xIBlackBird/furuta-pendulum/Pendel Down.jpeg

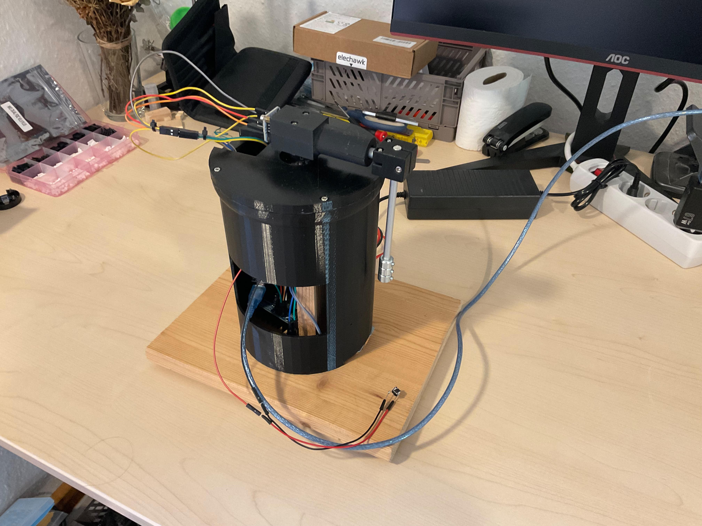
Pendel Down.jpeg
