xIBlackBird/furuta-pendulum/Pendel Up.jpeg

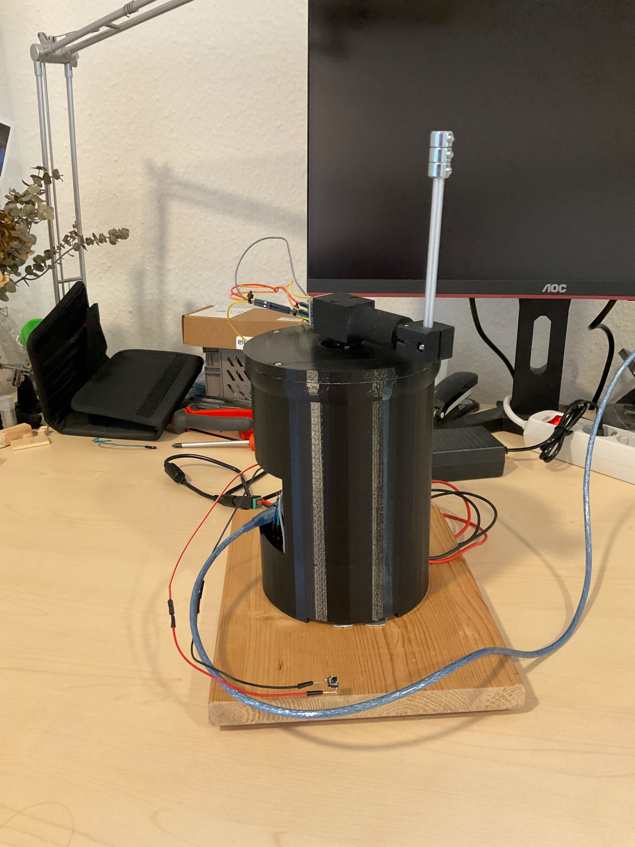
Pendel Up.jpeg
