xIBlackBird/furuta-pendulum/CAD/Zusammengesetzter Motorarm.SLDASM

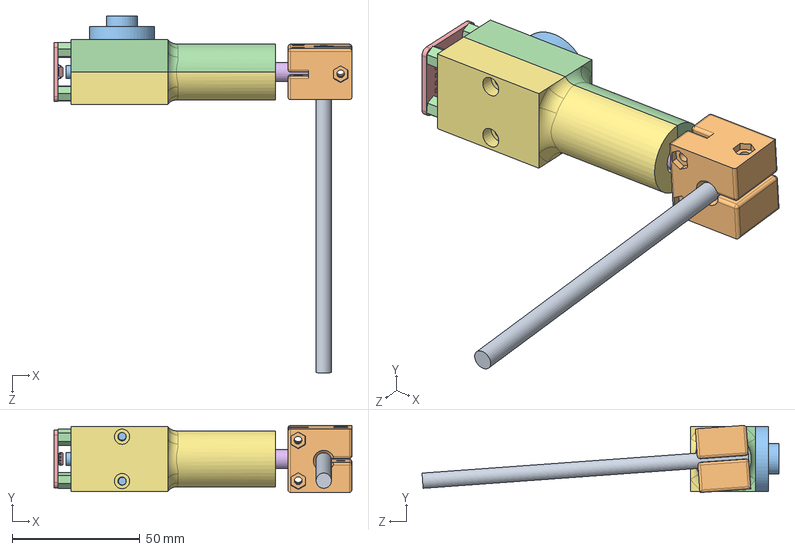
[picture p3: CAD file, 2026-09-04]
CAD/Zusammengesetzter Motorarm.SLDASM
116.6 x 26.3 x 139.8 mm
Motorarm_Unten_Link
Kupplung
M3 Mutter x 5
Kugellager x 2
Gewindeeinsätze x 8
Motorarm_Oben_Link
Welle
AS5600
Abstandshalter M3_5mm x 4
Magnet
Verbindung_Welle_Pendel
Pendelstange
