xIBlackBird/furuta-pendulum/CAD/Abdenkung Deckel.SLDPRT

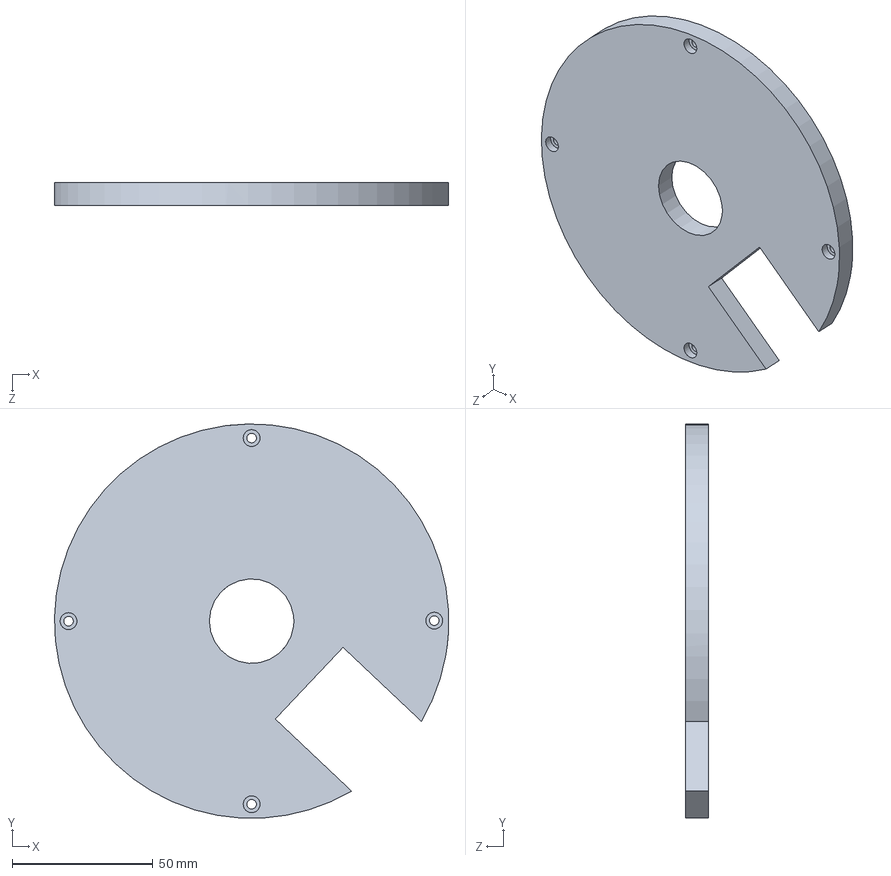
[picture p4: CAD file, 2026-10-30]
CAD/Abdenkung Deckel.SLDPRT
139.9 x 139.9 x 8.00 mm
