xIBlackBird/furuta-pendulum/CAD/Dateien zum Druck/Arduino Nano case.stl

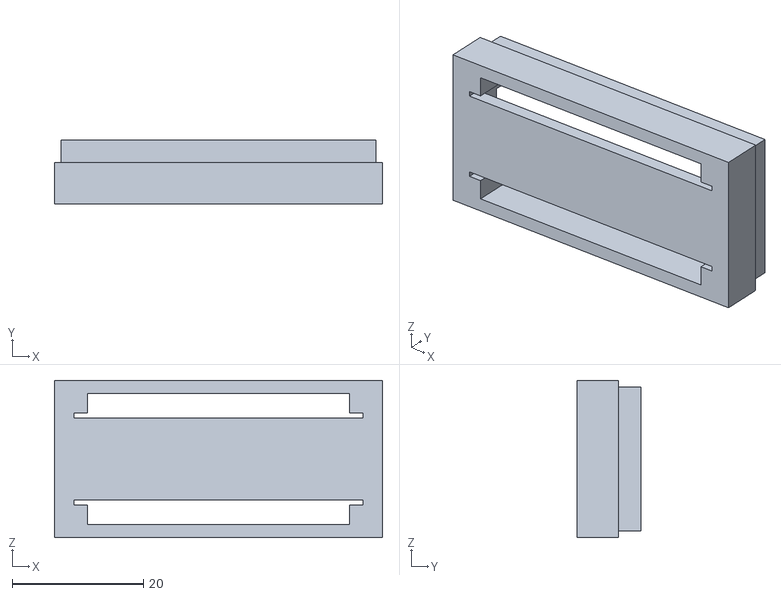
[picture p5: CAD file, 2026-10-30]
CAD/Dateien zum Druck/Arduino Nano case.stl
50.0 x 9.75 x 24.0
