xIBlackBird/furuta-pendulum/CAD/Motorarm Teile/Motorarm_Oben_Link.SLDPRT

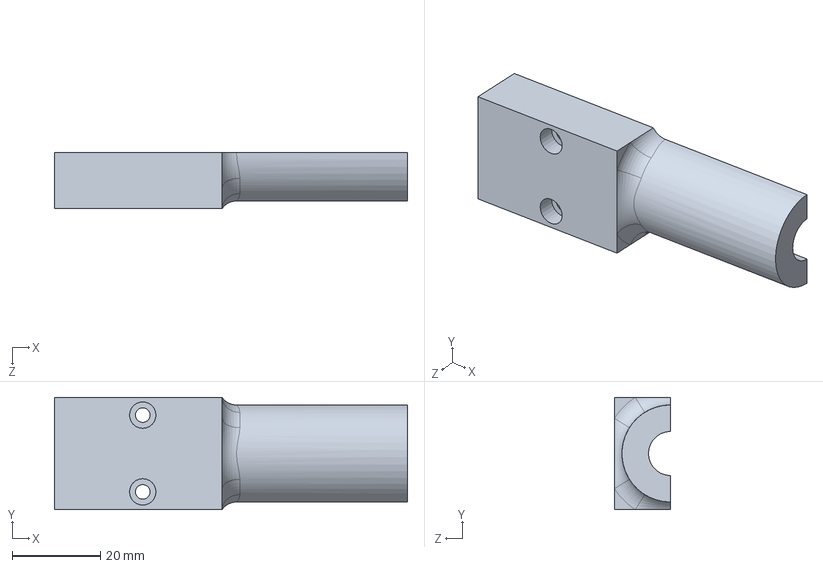
[picture p6: CAD file, 2026-09-04]
CAD/Motorarm Teile/Motorarm_Oben_Link.SLDPRT
80.0 x 25.4 x 12.7 mm
