xIBlackBird/furuta-pendulum/CAD/Abdenkung Zylinder.SLDPRT

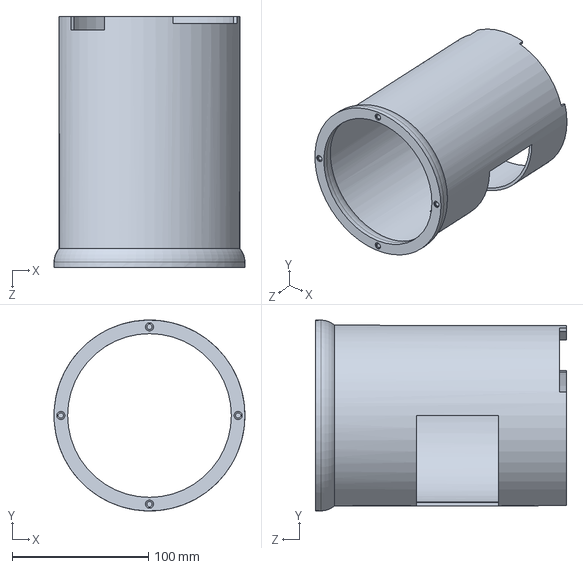
[picture p7: CAD file, 2026-10-30]
CAD/Abdenkung Zylinder.SLDPRT
140.0 x 139.9 x 184.0 mm
