xIBlackBird/furuta-pendulum/CAD/Dateien zum Druck/Arduino Nano Cover.stl

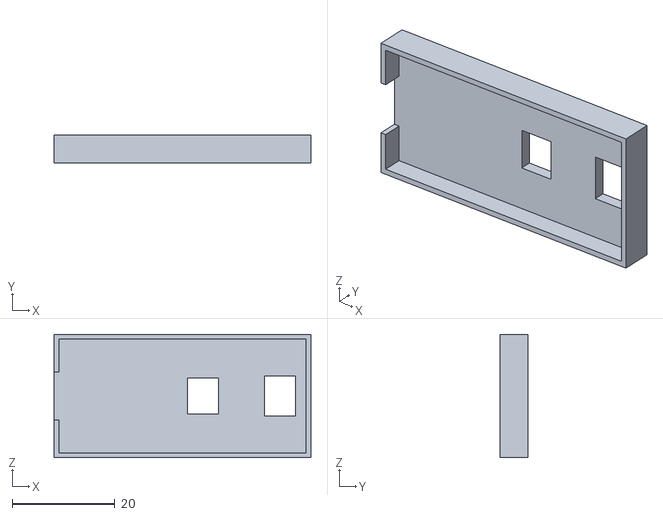
[picture p8: CAD file, 2026-10-30]
CAD/Dateien zum Druck/Arduino Nano Cover.stl
50.0 x 5.50 x 24.0
