xIBlackBird/furuta-pendulum/CAD/Motorarm Teile/Motorarm.SLDPRT

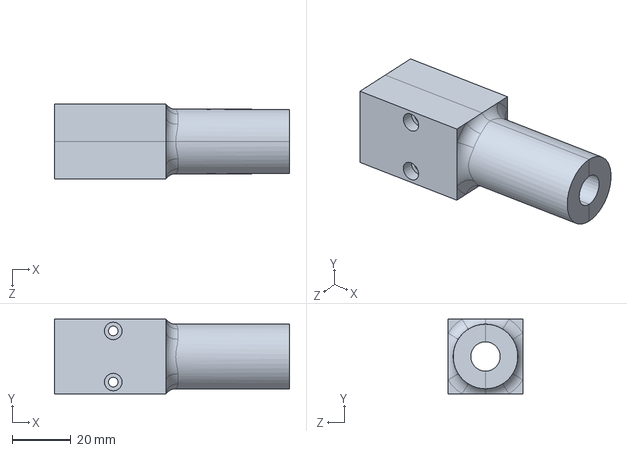
[picture p9: CAD file, 2026-09-04]
CAD/Motorarm Teile/Motorarm.SLDPRT
80.0 x 25.4 x 25.4 mm
