xIBlackBird/furuta-pendulum/CAD/bts7960_driver.SLDPRT

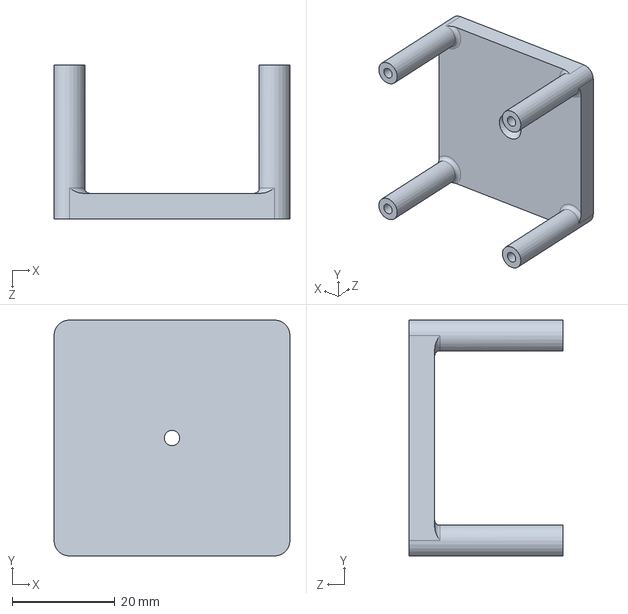
[picture p10: CAD file, 2026-10-30]
CAD/bts7960_driver.SLDPRT
46.0 x 46.0 x 30.0 mm
