xIBlackBird/furuta-pendulum/CAD/Motorarm Teile/Motorarm_Unten_Link.SLDPRT

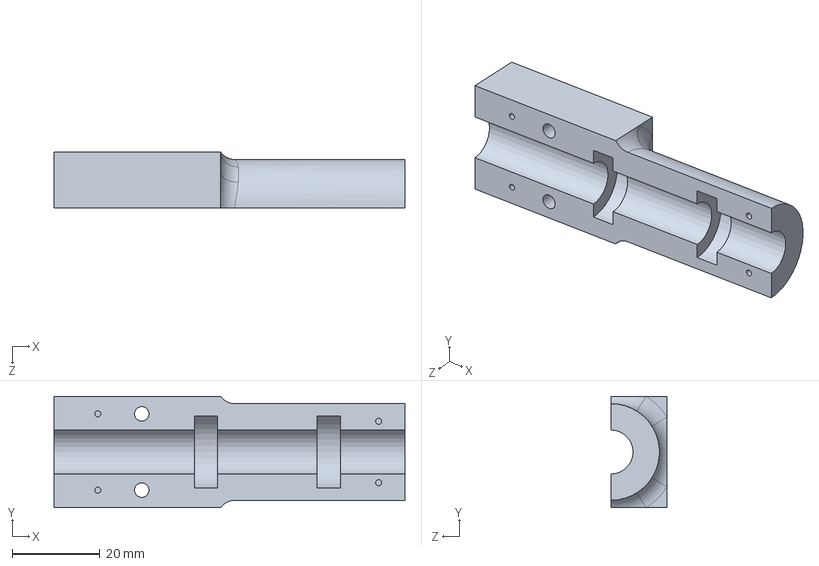
[picture p11: CAD file, 2026-09-04]
CAD/Motorarm Teile/Motorarm_Unten_Link.SLDPRT
80.0 x 25.4 x 12.7 mm
