xIBlackBird/furuta-pendulum/CAD/Welle.SLDPRT

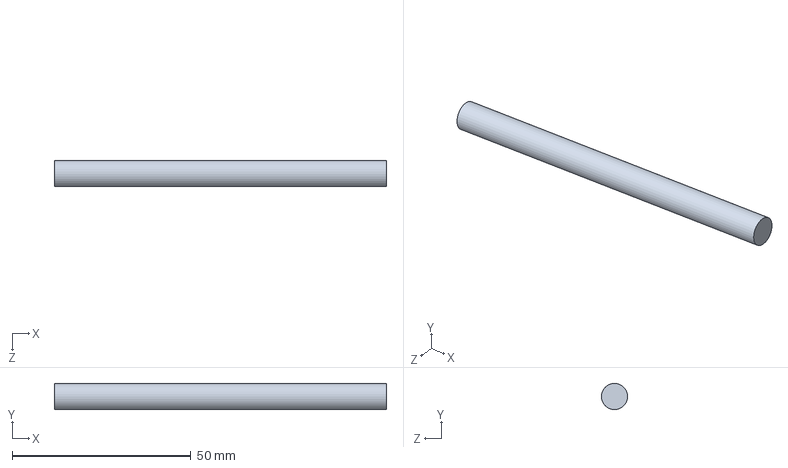
[picture p12: CAD file, 2026-09-04]
CAD/Welle.SLDPRT
93.0 x 7.34 x 7.35 mm
