xIBlackBird/furuta-pendulum/CAD/Pendelstange.SLDPRT

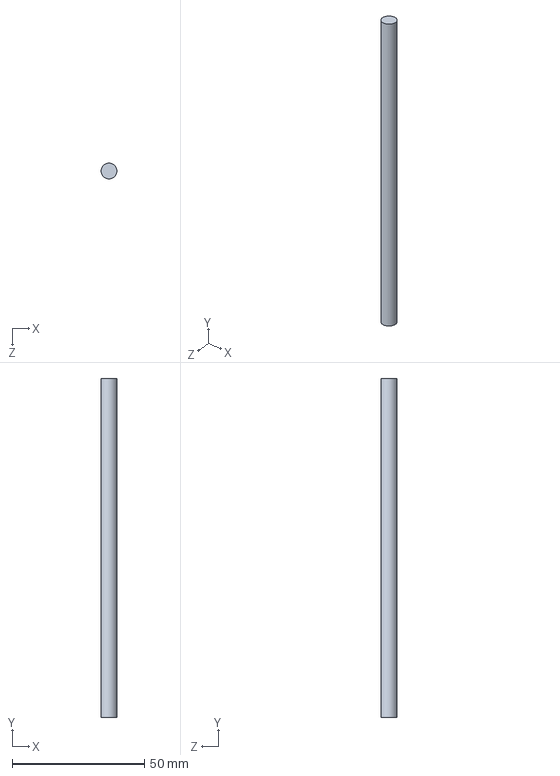
[picture p13: CAD file, 2026-09-04]
CAD/Pendelstange.SLDPRT
5.99 x 128.0 x 6.00 mm
