xIBlackBird/furuta-pendulum/CAD/Dateien zum Druck/Verbindung_Welle_Pendel.STL

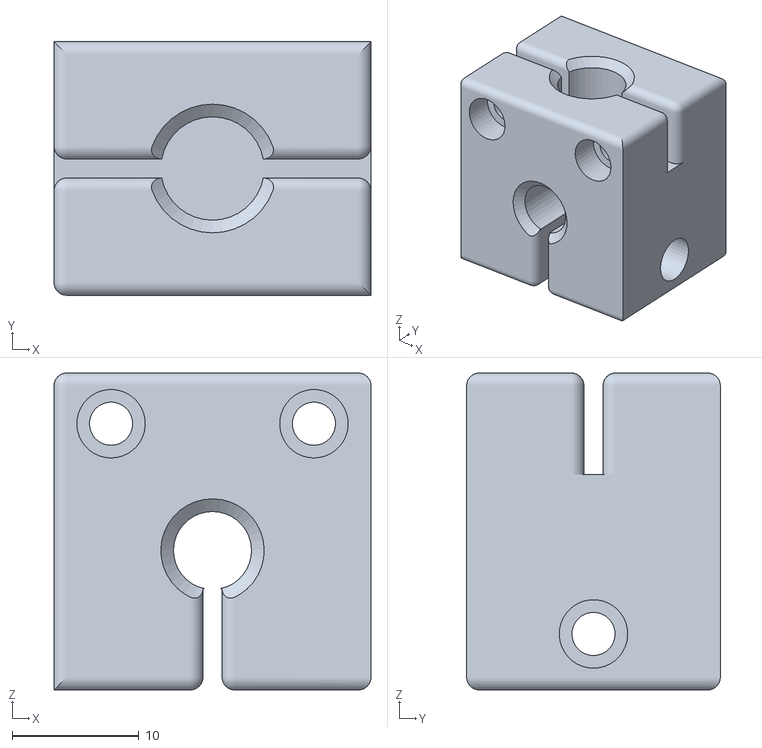
[picture p14: CAD file, 2026-09-04]
CAD/Dateien zum Druck/Verbindung_Welle_Pendel.STL
25.0 x 20.0 x 25.0
