xIBlackBird/furuta-pendulum/CAD/M3 Mutter.SLDPRT

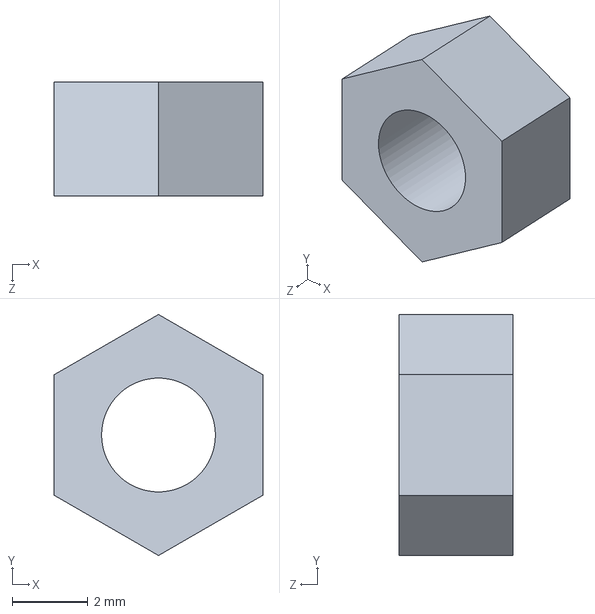
[picture p15: CAD file, 2026-09-04]
CAD/M3 Mutter.SLDPRT
5.50 x 6.35 x 3.00 mm
