xIBlackBird/furuta-pendulum/CAD/Kugellager.SLDPRT

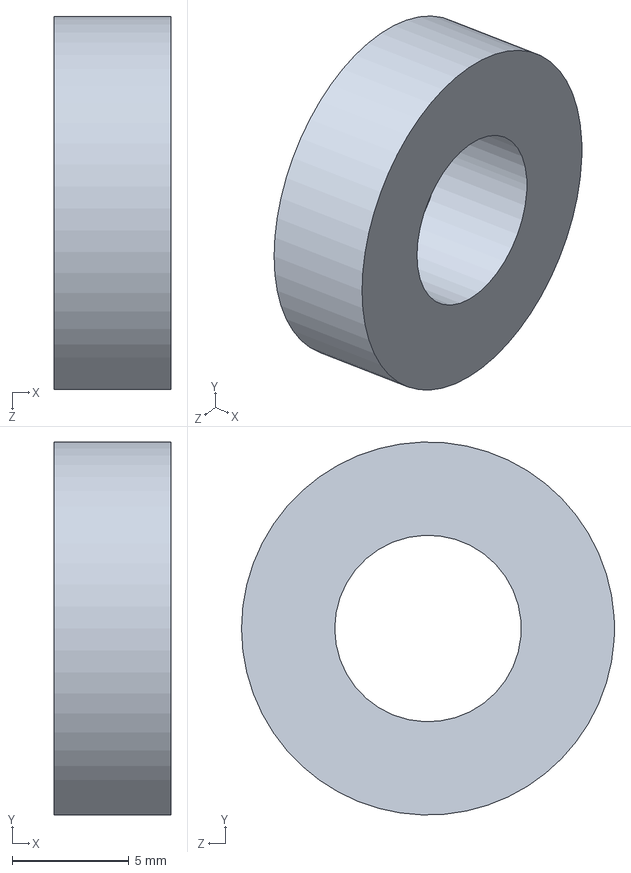
[picture p16: CAD file, 2026-09-04]
CAD/Kugellager.SLDPRT
5.00 x 16.0 x 16.0 mm
