xIBlackBird/furuta-pendulum/CAD/Magnet.SLDPRT

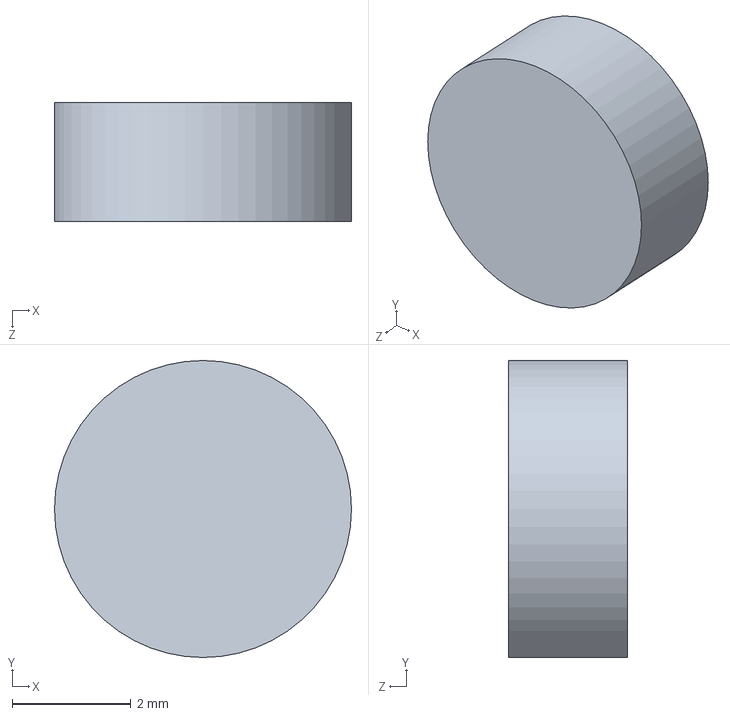
[picture p17: CAD file, 2026-09-04]
CAD/Magnet.SLDPRT
5.00 x 5.00 x 2.00 mm
