xIBlackBird/furuta-pendulum/CAD/Gewindeeinsätze.SLDPRT

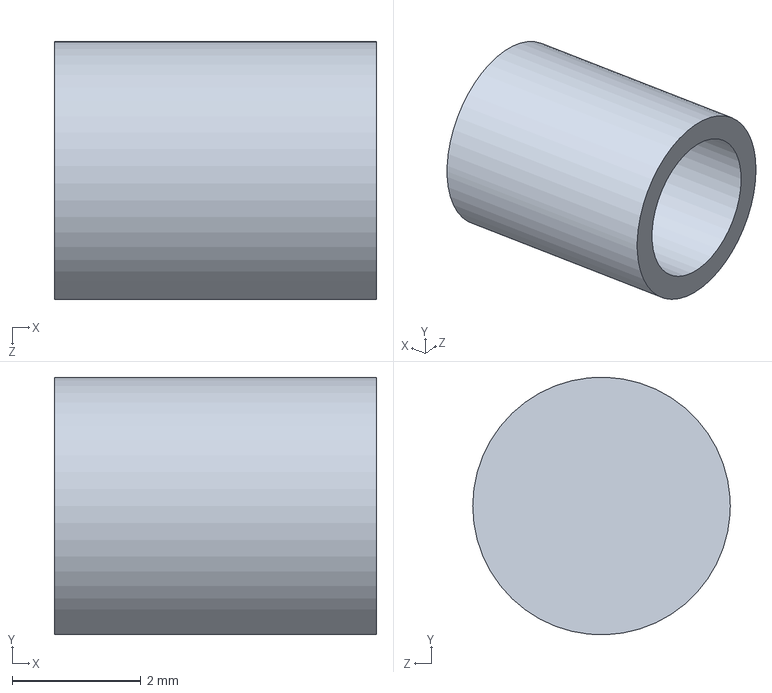
[picture p18: CAD file, 2026-08-29]
CAD/Gewindeeinsätze.SLDPRT
5.00 x 4.00 x 4.00 mm
