xIBlackBird/furuta-pendulum/CAD/Abstandshalter M3_5mm.SLDPRT

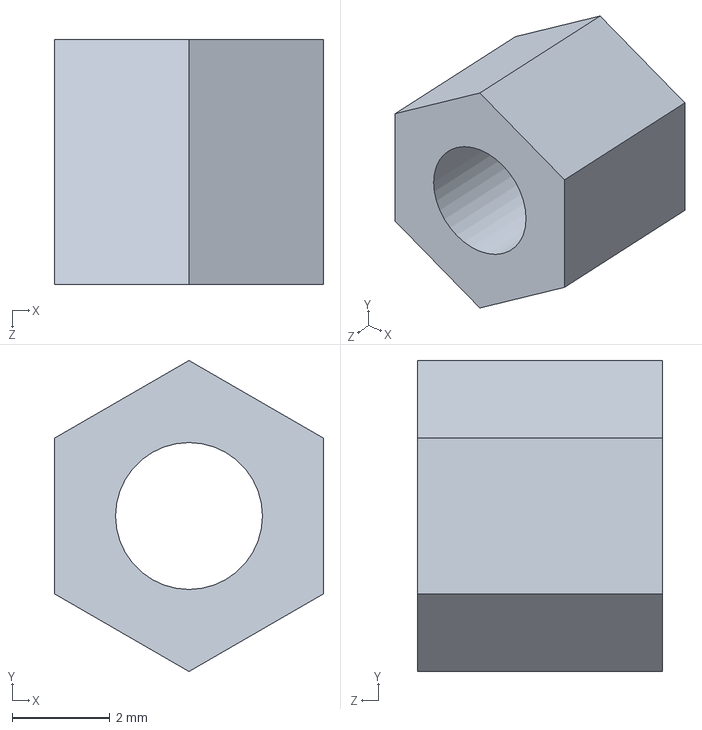
[picture p19: CAD file, 2026-08-29]
CAD/Abstandshalter M3_5mm.SLDPRT
5.50 x 6.35 x 5.00 mm
