xIBlackBird/furuta-pendulum/CAD/Kupplung.SLDPRT

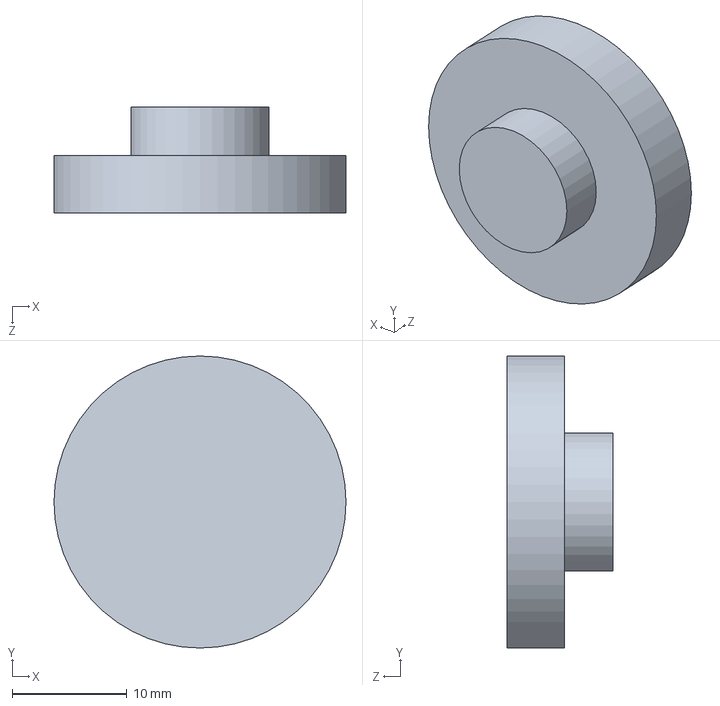
[picture p20: CAD file, 2026-08-29]
CAD/Kupplung.SLDPRT
25.4 x 25.4 x 9.20 mm
