xIBlackBird/furuta-pendulum/CAD/AS5600.SLDPRT

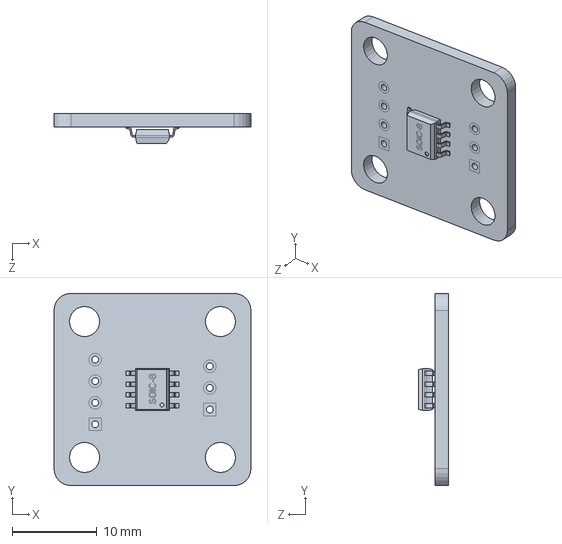
[picture p21: CAD file, 2026-08-29]
CAD/AS5600.SLDPRT
23.2 x 22.6 x 3.50 mm
