xIBlackBird/furuta-pendulum/(list of files, cad)

Other CAD files:
CAD/Dateien zum Druck/Abdenkung Zylinder.3MF
CAD/Dateien zum Druck/bts7960_driver.STL
CAD/Dateien zum Druck/Abdenkung Deckel.3MF
CAD/Verbindung_Welle_Pendel.SLDPRT
CAD/M3_10mm.SLDPRT
CAD/M3_16mm.SLDPRT
CAD/M3_20mm.SLDPRT
CAD/Motorarm Teile/Motorarm_Oben_Link.STL
CAD/Motorarm Teile/Motorarm_Unten_Link.STL
