xIBlackBird/furuta-pendulum/(commit log)

2026-08-27 Erster Push mit allen Sachen
    [KI-CAD.SLDPRT, Teil2.SLDPRT, main.SLDPRT]
2026-08-27 fertiger Motorarm
    [KI-CAD.SLDPRT, Motorarm.SLDPRT, Teil2.SLDPRT, main.SLDPRT]
2026-08-28 Aktueller CAD Status - Motorarm unten und oben fertig
    [Motorarm.SLDPRT, Motorarm_oben.3MF, Motorarm_oben.SLDPRT, Motorarm_oben.STL, Motorarm_unten.3MF, Motorarm_unten.SLDPRT, Motorarm_unten.STL]
2026-08-28 Q Matriz angepasst, EnergieTest gemacht, Sicherheitsnetz für Kabelschutz
    Q11 bringt den Motorarm schneller wieder zu phi1 = 0
    Energietest hat ein Vorzeichenfehler in der Corrioliskraft gezeigt (Wobei gemini die energiegleichung aufgestellt hat, also keine ahnung ob das valid ist.)
    Sicherheitsnetz im C-Code: Fängt den Arm bei überschreiten im kritischen Bereich ab und führt ihn langsam wieder zurück, damit der SwingUp durchgeführt werden kann
2026-08-29 fertiges CAD Modell des Motorarms
    [AS5600.SLDPRT, Abstandshalter M3_5mm.SLDPRT, Gewindeeinsätze.SLDPRT, Kugellager.SLDPRT, Kupplung.SLDPRT, M3 Mutter.SLDPRT, M3_10mm.SLDPRT, M3_20mm.SLDPRT]
2026-09-04 paar tests für den motor und aktualisierte cad dateien
    [Kugellager.SLDPRT, M3 Mutter.SLDPRT, M3_16mm.SLDPRT, Magnet.SLDPRT, Motorarm.SLDPRT, Motorarm_Oben_Link.SLDPRT, Motorarm_Oben_Link.STL, Motorarm_Unten_Link.SLDPRT]
2026-09-08 Test Skripts und init bereit für LQR Regler
2026-09-18 Datenlogging, Plots erstellen und SwingUp-Sequenz
2026-09-23 lqr mit Button gesteuert
    [Abdenkung Zylinder.SLDPRT]
